sebseb7/SbusToPPM/sbus.jpg

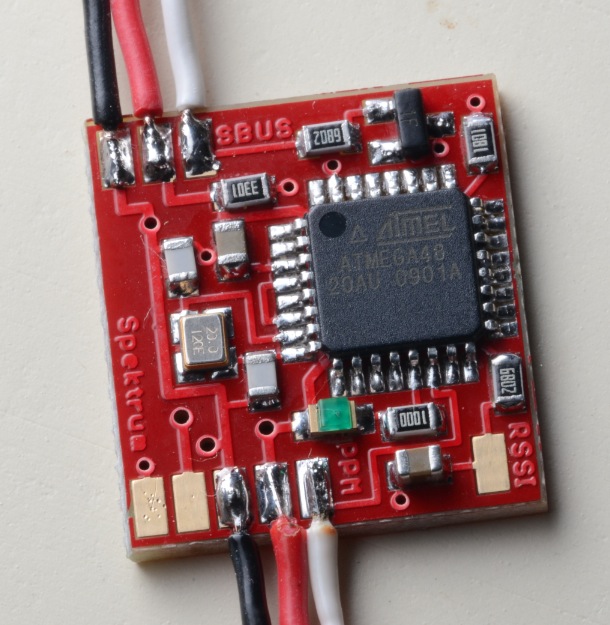
sbus.jpg
