sebseb7/SbusToPPM/sbus-ppm.png

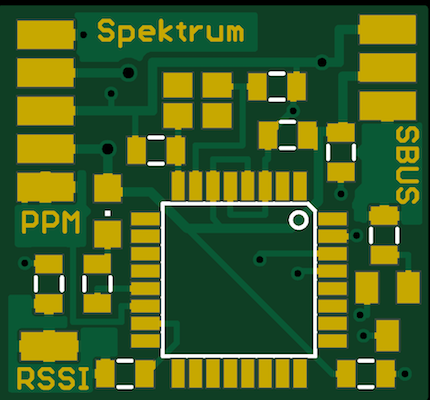
sbus-ppm.png
