sebseb7/SbusToPPM/README

This small Converter converts Futaba SBus Signal (inverted serial 100000 baud) to PPM (Pulse Position Modulation) or Spektrum Serial (serial 115200 baud)

I also sell them for 10 Euro (complete) or 1 Euro (pcb only)
