sebseb7/SbusToPPM/README.mkd

This small Converter converts Futaba SBus Signal (inverted serial 100000 baud) to PPM (Pulse Position Modulation) or Spektrum Serial (serial 115200 baud)

pcb

sbus
