sebseb7/SbusToPPM/sbus-ppm.brd

## EAGLE design sbus-ppm.brd (2016-05-01)

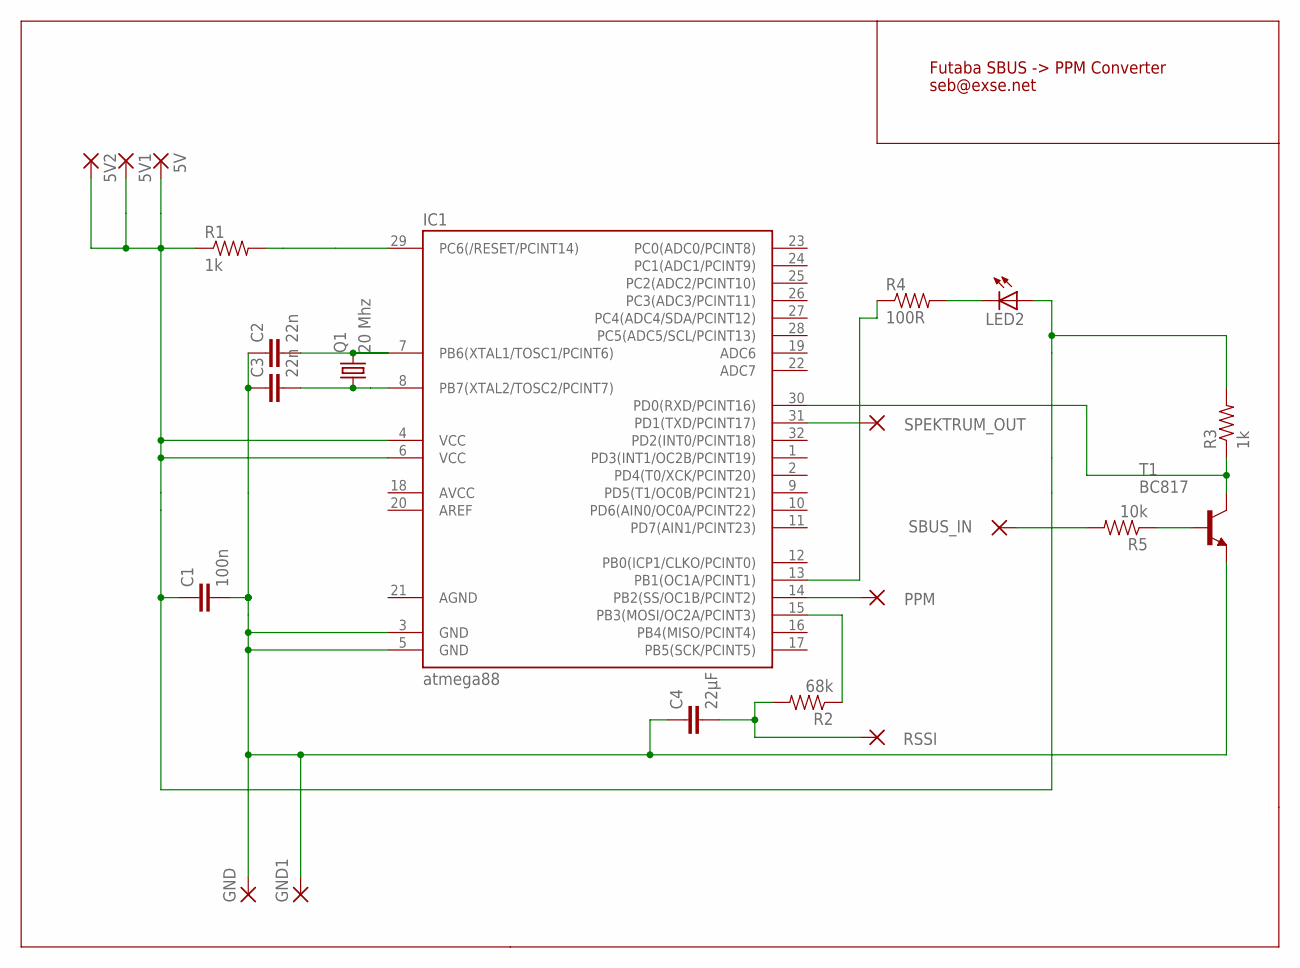
[picture p3: schematic sbus-ppm.sch]

Parts:
5V, 5V1, 5V2: SMD2; SMD1,27-2,54
C1: 100n; 0805
C2, C3: 22n; 0805
C4: 22µF; 0805
GND, GND1: SMD2; SMD1,27-2,54
IC1: atmega88; TQFP32-08
LED2: LEDCHIPLED_0805; CHIPLED_0805
PPM: SMD2; SMD1,27-2,54
Q1: 20 Mhz; X22
R1, R3: 1k; 0805
R2: 68k; 0805
R4: 100R; 0805
R5: 10k; 0805
RSSI: SMD2; SMD1,27-2,54
SBUS_IN: SMD2; SMD1,27-2,54
SPEKTRUM_OUT: SMD2; SMD1,27-2,54
T1: BC817; SOT23

Connections:
+5V: 5V.1, 5V1.1, 5V2.1, C1.1, IC1.4 (VCC), IC1.6 (VCC), LED2.A, R1.1, R3.2
AGND: IC1.21 (AGND)
GND: C1.2, C2.1, C3.1, C4.1, GND.1, GND1.1, IC1.3 (GND), IC1.5 (GND), T1.2 (E)
unnamed: IC1.15 (PB3(MOSI/OC2A/PCINT3)), R2.1
unnamed: IC1.14 (PB2(SS/OC1B/PCINT2)), PPM.1
unnamed: R5.2, SBUS_IN.1
unnamed: C4.2, R2.2, RSSI.1
unnamed: IC1.29 (PC6(/RESET/PCINT14)), R1.2
unnamed: C3.2, IC1.8 (PB7(XTAL2/TOSC2/PCINT7)), Q1.1
unnamed: C2.2, IC1.7 (PB6(XTAL1/TOSC1/PCINT6)), Q1.3 (2)
unnamed: R5.1, T1.1 (B)
unnamed: IC1.31 (PD1(TXD/PCINT17)), SPEKTRUM_OUT.1
unnamed: LED2.C, R4.2
unnamed: IC1.13 (PB1(OC1A/PCINT1)), R4.1
unnamed: IC1.30 (PD0(RXD/PCINT16)), R3.1, T1.3 (C)

Notes on the sheet:
Futaba SBUS -> PPM Converter
seb@exse.net

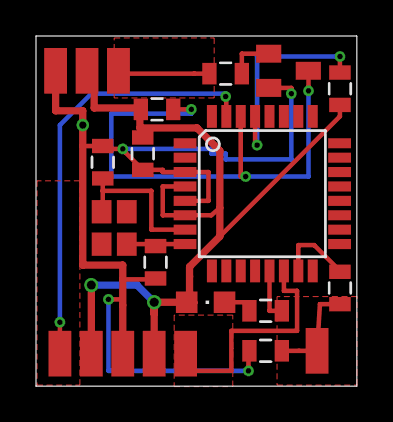
[picture p4: board sbus-ppm.brd from above]

Board: 2 copper layers, 17.8 x 19.5 mm, 22 parts (0 on the bottom side), 14 nets.
