sebseb7/SbusToPPM/(threads)

Thread 2 (2015-05-25):

Questions about using this with Spektrum

RyanEwen, 2015-05-25:
Hello!

I can't find any method of contacting you other than through the issue tracker..

I have used your schematic and code to build my own SBus to Spektrum converter. It's nearly done (board built, chip programmed) and today I did a quick test to see if it would work with my flight controller (which only works with Spektrum receivers). My flight controller is from a Blade QX3 and the stock receiver for it looks the same as a Spektrum remote receiver.

I want to use my FrSky X8R instead of the Spektrum receiver. This is why I am trying to convert FrSky SBus (same as Futuba?) to Spektrum.

Tonight I will be sniffing the line to see what is output from this board compared to what is output from the stock Spektrum RX.

I just wanted to know if you had tested and finalized the Spektrum output? I imagine most people use PPM instead.

Thanks,
Ryan

sebseb7, 2015-07-13:
yes I tested spektrum output.

do you have an oszilloscope ?

RyanEwen, 2015-07-14:
Hi and thanks for the reply!

There is an issue with my board, it oscillates but the signal it not output. I cannot even get an LED to light up with it and my own code. So I put it aside and I ordered one of these:

http://www.banggood.com/ATmega328P-Nano-V3-Controller-Board-Compatible-Arduino-p-940937.html

It's arrived and I need to add the components onto it and program it. Since it is 16mhz I will need to make some changes to the code. I am very new to this kind of programming/project (I am a software engineer) so any tips you may have are much appreciated.

Also, is it possible to buy the board you designed somewhere?

sebseb7, 2015-07-17:
it's not a commercial project. You can send me your board and I will try to fix it. (and describe you any issues I found)

Did you had any issues running my code on an arduino?

RyanEwen, 2015-07-17:
I think me and my friend probably made a mistake assembling our first board. As I said we can't get it to even run our own simple code to light up an LED. So that is our fault.

While we are trying to figure out our first board, I ordered a premade board (the one linked above from banggood) to try instead so I will see how that goes. This new board is 16mhz and your design is 20mhz so I will need to learn how to update the code for the different timings.

I have no experience in Arduino and ordered the new board without realizing it's an Arduino clone. I planned to use Atmel Studio again. I don't think I should treat it like an Arduino for this.

sebseb7, 2015-07-22:
just solder a 20Mhz quartz in and you are fine.

RyanEwen, 2015-07-22:
I was hoping to keep the 16mhz since it's surface mounted and very small and clean. The 20mhz crystal I have is very very big.

sebseb7, 2015-07-31:
can you just send me the board you soldered ? I'd like to fix it :-)

RyanEwen, 2015-08-06:
I will take you up on this offer. Can we chat elsewhere?

My email is ryan (at) ryan-ewen (dot) com
I also use Google Hangouts for instant messaging.

RyanEwen, 2015-11-13:
Hi again,

I haven't heard from you. I am still interested in this project :)

RyanEwen, 2016-04-24:
I found many suppliers of your board! I guess it got popular. I will buy from one of them :)

http://www.readytoflyquads.com/sbus-to-ppm-or-spektrum-serial

http://www.banggood.com/Converter-from-SBUS-to-PPM-or-Spektrum-Serial-p-1016366.html

http://www.aliexpress.com/item/SBUS-TO-PPM-OR-SPEKTRUM-SERIAL/32421262657.html

sebseb7, 2016-05-01:
haha nice.

they even build a quite old commit.

this one:
https://github.com/sebseb7/eagle/blob/ab4d1bcaeac4c49a2d584f54036f66ff47513380/sbus-ppm/sbus-ppm.brd

2016-04-24 6:06 GMT+02:00 Ryan Ewen <notifications@github.com>:

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

RyanEwen, 2016-05-02:
Has anything important changed?

sebseb7, 2016-05-02:
no, nothing. but I can't see what kind of crystal they are using.

RyanEwen, 2016-05-06:
My board arrived but it's extremely hard to read the writing on the crystal. T20C is the top line. Up1R is the bottom line.

sebseb7, 2016-08-22:
Can someone extract the firmware they ship with it?

Thread 3 (2016-05-05):

5V or 3.3V on Spektrum VCC pad

RyanEwen, 2016-05-05:
Hi again,

I received a board based on your design and have a question about the voltage of the Spektrum output. My flight controller isn't responding to the Spektrum output, so I am trying to figure out the issue.

#What does work so far:
* The flight controller seems to recognize the presence of the board (it beeps and complains if absent).
* The LED flashes on the board. Bursts of fast flashes if TX is not turned on. Steady slow flashes if TX is turned on.

#What doesn't work so far:
* The flight controller doesn't seem to recognize that I'm sending channel data.

*Note:* This is a non-configurable flight controller from Blade 350 QX3. It is only meant to work with included Spektrum satellite RX.

From reading about Spektrum satellite RXs I think they only work on 3.3V, and my flight controller does output 3.3V. A possible problem I see is that my multimeter reads 5V between Spektrum VCC pad and GND on the PCB based upon your design. I expected it to read 3.3V when connected to the flight controller. I assume the 5V reading comes through the board from SBUS on the other side.. Is this a problem?

Also, does this mean PCB is sending 5V Spekrum serial signal when maybe it should only be 3.3V?

#Things I tried:
* Disconnecting Spektrum VCC line to flight controller. I don't think it's needed if the PCV is already powered, right?.
* Connecting Spektrum VCC and disconnecting SBUS VCC in order to power the PCB using 3.3V. The board doesn't power up that way.

Tonight if I am able to I will try to read Spektrum serial output from PCB to make sure it is outputting data.

Thanks for any help.

sebseb7, 2016-05-09:
you cannot power the the but a 3.3v AND 5V, this would result in a short.

if your board is not 5V tolerant, you can use 2 diodes to reduce the voltage.

the mega88pa can work at 3.3v is configured correctly.

compare the output to the output of you original spektrum receiver, there are different versions (resolution/
channels)

RyanEwen, 2016-05-09:
I will compare output soon. I realized after looking at the source code that maybe Spektrum output could be DSM2 22ms when I want DSMX 11ms. None of the sellers specify the settings used when programming the chip.

Thread 5 (2016-10-06):

Programming advice

athertop, 2016-10-06:
Hi Seb,

Sorry to bother you here but can't find any other way to get in touch.

I'm wondering if there is a programming guide anywhere for flashing your code to the Atmel Mega88 chip?

I purchased a version of your board from here: http://www.banggood.com/Converter-from-SBUS-to-PPM-or-Spektrum-Serial-p-1016366.html?rmmds=search

but it seems to be 8ch only - I am looking for configuring for 12ch PPM. I have Windows with AVRDUDE installed and can easily get an Atmel flashing tool. Wondering how I compile and flash.

Many thanks in advance, Paul

athertop, 2016-10-06:
I figured how to compile a hex file - after following toolchain install notes for the mac from here: http://maxembedded.com/2015/06/setting-up-avr-gcc-toolchain-on-linux-and-mac-os-x/

Just wondering if any special considerations for programming the chip with avrdude (probably with the avrdudess gui

sebseb7, 2016-10-13:
To update the firmware you need to connect an AVR programmer to the atmel chip, then you should be able to flash the firmware. Please be aware that those boards are "clones" I do not know what kind of crystal they are using or what kind of firmware they use. I have no problem with those "clones". But I don't feel in charge of doing customer care support for them. ;-)

athertop, 2016-11-24:
Sebseb7, I'm glad to advise that the clone boards on banggood work just fine with your code. I now have 12 channels over ppm (instead of just 8 as it came delivered). I would like to thank you for such a great project. I just now need to figure how to squeeze in 16 channels. Thanks again

Closed 2016-10-13.

Thread 6 (2017-04-20):

Programming the MCU

yashm, 2017-04-20:
I noticed that the ISP pins are not broken out . Does this board require pre-flashing the MCU before soldering on to the PCB?

Also, I was just wondering if this project is still active?

Thanks!

sebseb7, 2017-04-21:
Yes you need to flash a bootloader first. They you can use the SBUS pins. I still use the hardware. But I would suggest using this chip today: https://github.com/sebseb7/lpc8xx

yashm, 2017-04-21:
Hi Seb, Thanks for a prompt reply!

I am planning to make my own layout for my university research project, so I might just add the "SbusToPPM" schematic on the same PCB and breakout the usual SPI pins out and flash it that way. Would you be OK with this?

Thanks!

sebseb7, 2017-04-22:
sure. You can also use the code without any restrictions. (BSD 0-Clause)

Closed 2017-04-21.

Thread 7 (2017-10-17):

SBUS to PPM for Futaba Radio Help

bishko, 2017-10-17:
Dear sebseb7,

I couldn't find another way to contact you so I am contacting you like this.

I have the purchased the [SBUS to PPM decoder](https://www.aliexpress.com/item/RCTimer-Tiny-Converter-SBUS-TO-PPM-or-SpeSerial-Receiver-Freeshipping/32685683269.html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) from you and I was hoping that you can help me with the setup.

I have a [Futaba T14SG transmitter](http://manuals.hobbico.com/fut/14sg-manual.pdf) and a [Futaba R7008SB receiver](http://manuals.hobbico.com/fut/r7008sb-manual.pdf) set to "Mode B". Mode B is the mode where CH8 on the receiver becomes the S.BUS port for SBUS servos for example. However, I would like all channels to go through the S.BUS port, i.e. Channels 1 to 8 so that using a decoder, I can convert the S.BUS to a PPM-Combined for channels 1 to 8. I have the decoder wired to channel 8 on the receiver however I am not sure if there is something that I need to do on the transmitter to make this work. As mentioned, the transmitter I am using is a T14SG. I am decoding to PPM because I want to connect to the ImmersionRC Long range transmitter and this only takes PPM as an input. Images are attached below.

I initially thought that I need to register the PPM encoder with the T14SG the way that an SBUS servo is registered, however, I was not successful in my attempts and therefore I am contacting you in hopes that you will be able to explain to me what I am doing wrong and how to do it right.

Thank you in advance for your help!

Images of my intended setup:
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

sebseb7, 2017-10-20:
I do not sell these adapters, this is a clone.

sebseb7, 2017-10-20:
I have no idea what kind of software it is running. (mine or theirs)

sebseb7, 2017-10-20:
with my software you should have 8 or 12 channels.

sebseb7, 2017-10-20:
if you need help contact me:

twitter.com/sebseb7
facebook.com/seb.greenbus
